rough-rat/papajbadge/muzg/papajbadge.kicad_pcb

## KiCad design muzg/papajbadge.kicad_pcb (2025-09-09)

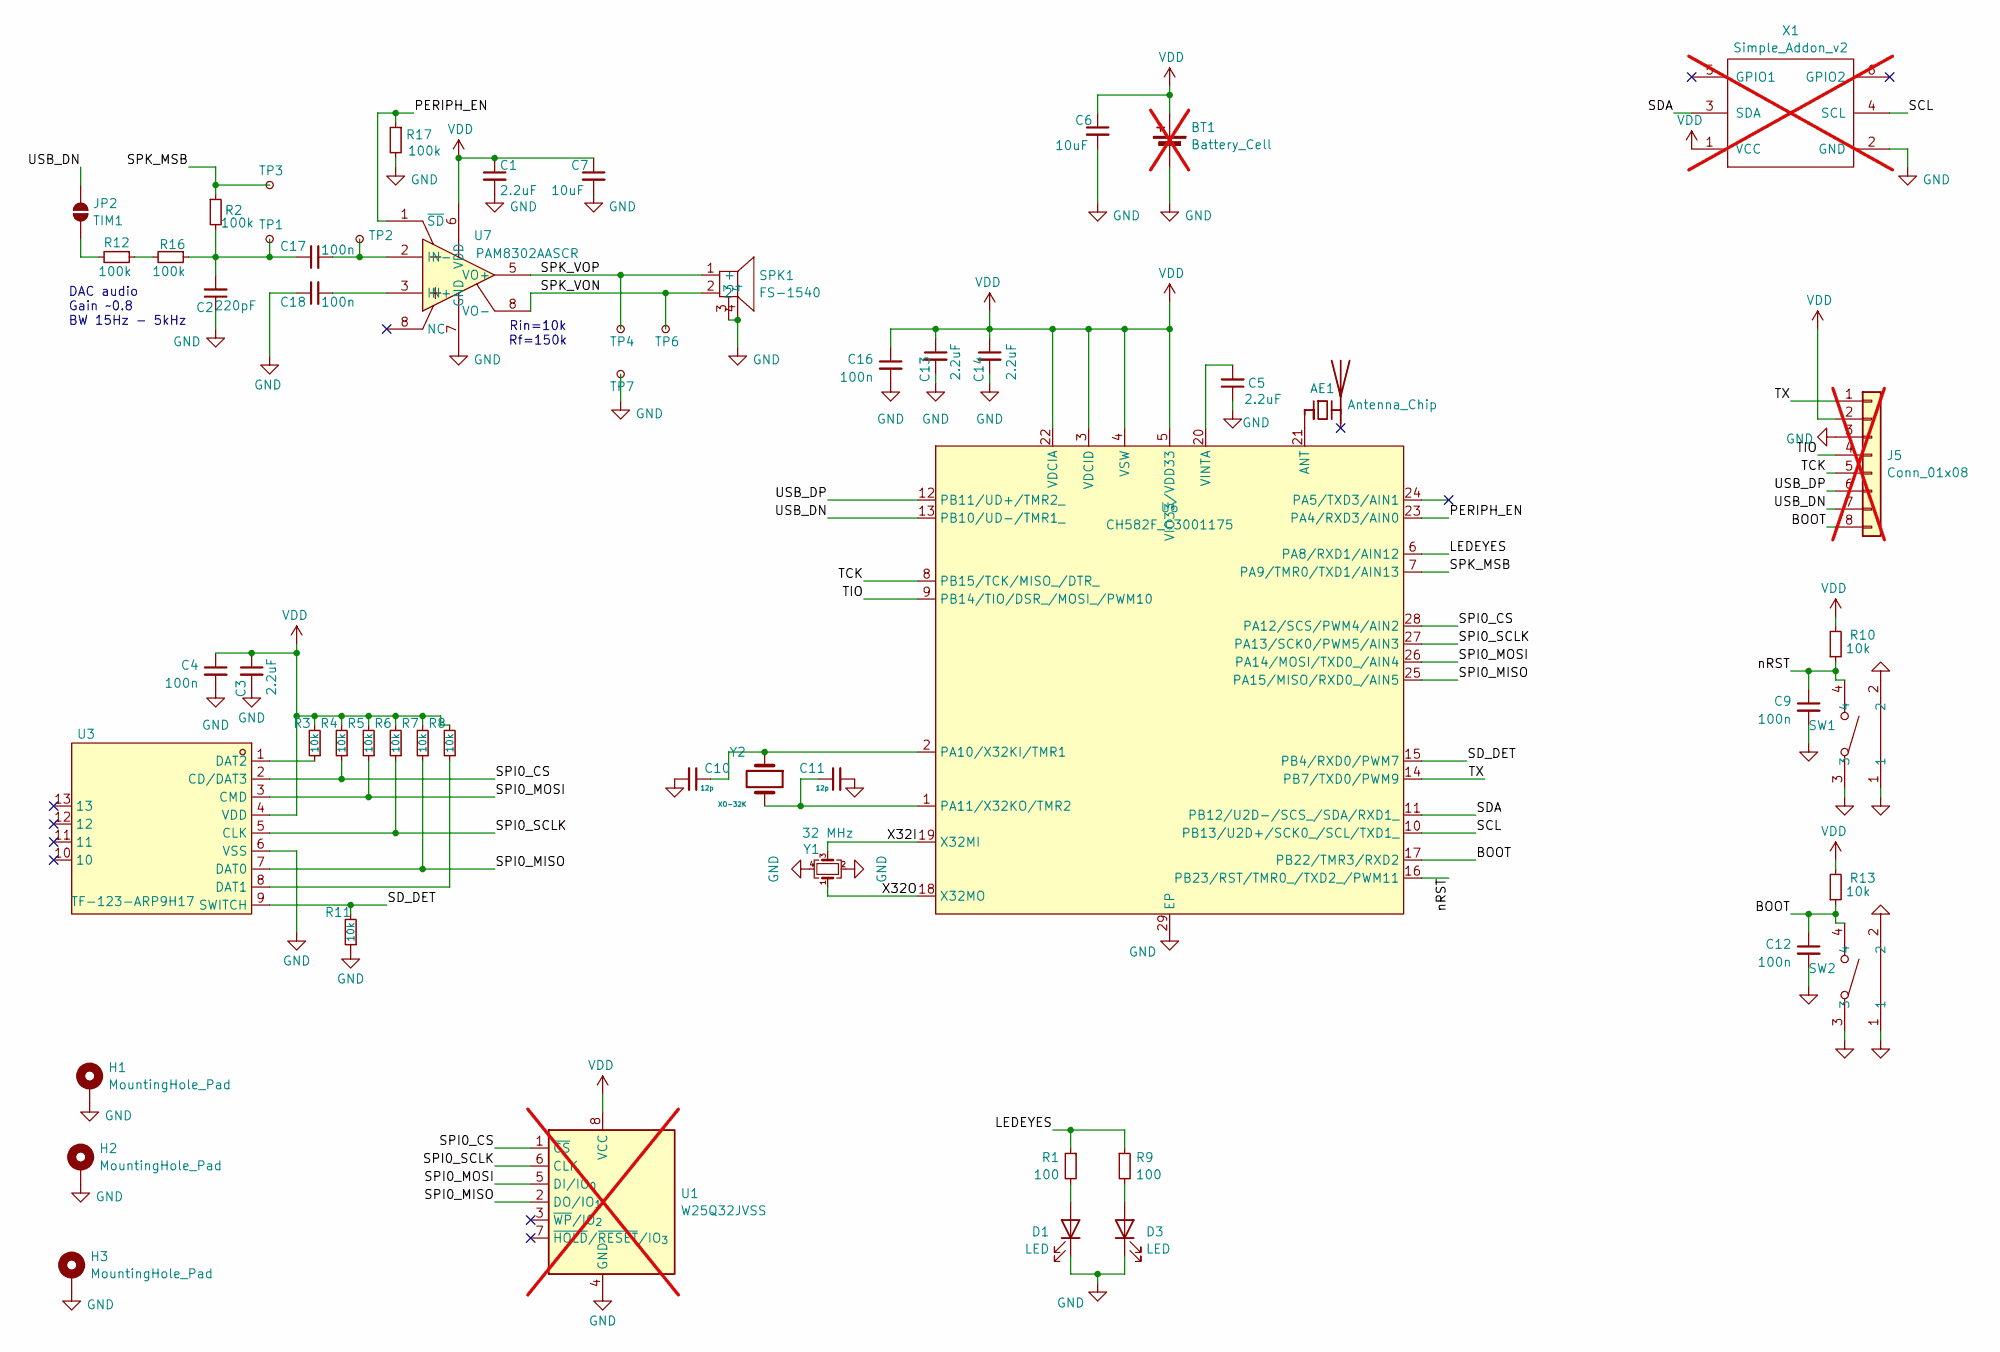
[picture p2: schematic papajbadge.kicad_sch]

Parts:
AE1: Antenna_Chip; Johanson_2450AT18x100; LCSC C127629
BT1: Battery_Cell; BatteryHolder_Multicomp_BC-2001_1x2032; not fitted
C1, C3, C5, C13, C14: 2.2uF; C_0402_1005Metric
C2: 220pF; C_0402_1005Metric
C4, C9, C12, C16, C17, C18: 100n; C_0402_1005Metric
C6, C7: 10uF; C_0603_1608Metric
C10, C11: 12p; C_0402_1005Metric
D1, D3: LED; LED_0603_1608Metric
H1, H2, H3: MountingHole_Pad; MountingHole_2.7mm_M2.5_DIN965_Pad
J5: Conn_01x08; PinSocket_1x08_P2.54mm_Vertical; not fitted
JP2: TIM1; SolderJumper-2_P1.3mm_Open_RoundedPad1.0x1.5mm
R1, R9: 100; R_0402_1005Metric
R2, R12, R16, R17: 100k; R_0402_1005Metric
R3, R4, R5, R6, R7, R8, R10, R11, R13: 10k; R_0402_1005Metric
SPK1: FS-1540; BUZ-SMD_5P-L15.0-W15.0-P13.7-BL; LCSC C482341
SW1, SW2: TS24CA; SW-SMD_TS24CA; LCSC C393942
TP1, TP2, TP3: RX; TestPoint_Pad_D0.6mm
TP4, TP6, TP7: RX; TestPoint_Pad_D1.0mm
U1: W25Q32JVSS; SOIC-8_5.3x5.3mm_P1.27mm; not fitted
U3: TF-123-ARP9H17; TF-SMD_TF-123-ARP9H15; LCSC C2982548
U6: CH582F_C3001175; QFN-28_L4.0-W4.0-P0.40-BL-EP2.8; LCSC C3001175
U7: PAM8302AASCR; MSOP-8_L3.0-W3.0-P0.65-LS5.0-BL; LCSC C113367
X1: Simple_Addon_v2; PinHeader_2x03_P2.54mm_Vertical; not fitted
Y1: 32 MHz; Crystal_SMD_2016-4Pin_2.0x1.6mm; LCSC C2682773
Y2: XO-32K; Crystal_SMD_2012-2Pin_2.0x1.2mm; LCSC C7500573

Connections:
/BOOT: C12.1, J5.8, R13.1, SW2.4, U6.17 (PB22/TMR3/RXD2)
/LEDEYES: R1.1, R9.1, U6.6 (PA8/RXD1/AIN12)
/PERIPH_EN: R17.1, U6.23 (PA4/RXD3/AIN0), U7.1 (~SD)
/SCL: U6.10 (PB13/U2D+/SCK0_/SCL/TXD1_), X1.4 (SCL)
/SDA: U6.11 (PB12/U2D-/SCS_/SDA/RXD1_), X1.3 (SDA)
/SD_DET: R11.2, U3.9 (SWITCH), U6.15 (PB4/RXD0/PWM7)
/SPI0_CS: R4.1, U1.1 (~CS), U3.2 (CD/DAT3), U6.28 (PA12/SCS/PWM4/AIN2)
/SPI0_MISO: R7.1, U1.2 (DO/IO_{1}), U3.7 (DAT0), U6.25 (PA15/MISO/RXD0_/AIN5)
/SPI0_MOSI: R5.1, U1.5 (DI/IO_{0}), U3.3 (CMD), U6.26 (PA14/MOSI/TXD0_/AIN4)
/SPI0_SCLK: R6.1, U1.6 (CLK), U3.5 (CLK), U6.27 (PA13/SCK0/PWM5/AIN3)
/SPK_MSB: R2.1, TP3.1, U6.7 (PA9/TMR0/TXD1/AIN13)
/SPK_VON: SPK1.2, TP6.1, U7.8 (VO-)
/SPK_VOP: SPK1.1 (+), TP4.1, U7.5 (VO+)
/TCK: J5.5, U6.8 (PB15/TCK/MISO_/DTR_)
/TIO: J5.4, U6.9 (PB14/TIO/DSR_/MOSI_/PWM10)
/TX: J5.1, U6.14 (PB7/TXD0/PWM9)
/USB_DN: J5.7, JP2.2 (B), U6.13 (PB10/UD-/TMR1_)
/USB_DP: J5.6, U6.12 (PB11/UD+/TMR2_)
/X32I: U6.19 (X32MI), Y1.3
/X32O: U6.18 (X32MO), Y1.1
/nRST: C9.1, R10.1, SW1.4, U6.16 (PB23/RST/TMR0_/TXD2_/PWM11)
GND: BT1.2 (-), C1.2, C2.1, C3.2, C4.2, C5.1, C6.2, C7.2, C9.2, C10.2, C11.2, C12.2, C13.2, C14.2, C16.2, C18.1, D1.1 (K), D3.1 (K), H1.1, H2.1, H3.1, J5.3, R11.1, R17.2, SPK1.3, SPK1.4, SW1.1, SW1.2, SW1.3, SW2.1, SW2.2, SW2.3, TP7.1, U1.4 (GND), U3.6 (VSS), U6.29 (EP), U7.7 (GND), X1.2 (GND), Y1.2, Y1.4
unnamed: AE1.1 (FEED), U6.21 (ANT)
unnamed: C2.2, C17.1, R2.2, R16.1, TP1.1
unnamed: D1.2 (A), R1.2
unnamed: D3.2 (A), R9.2
unnamed: JP2.1 (A), R12.2
unnamed: R12.1, R16.2
unnamed: R8.1, U3.8 (DAT1)
unnamed: R3.1, U3.1 (DAT2)
unnamed: C10.1, U6.2 (PA10/X32KI/TMR1), Y2.1
unnamed: C11.1, U6.1 (PA11/X32KO/TMR2), Y2.2
unnamed: C5.2, U6.20 (VINTA)
unnamed: C18.2, U7.3 (IN+)
unnamed: C17.2, TP2.1, U7.2 (IN-)
VDD: BT1.1 (+), C1.1, C3.1, C4.1, C6.1, C7.1, C13.1, C14.1, C16.1, J5.2, R3.2, R4.2, R5.2, R6.2, R7.2, R8.2, R10.2, R13.2, U1.8 (VCC), U3.4 (VDD), U6.3 (VDCID), U6.4 (VSW), U6.5 (VIO33/VDD33), U6.22 (VDCIA), U7.6 (VDD), X1.1 (VCC)

Notes on the sheet:
Rin=10k Rf=150k
DAC audio Gain ~0.8 BW 15Hz - 5kHz

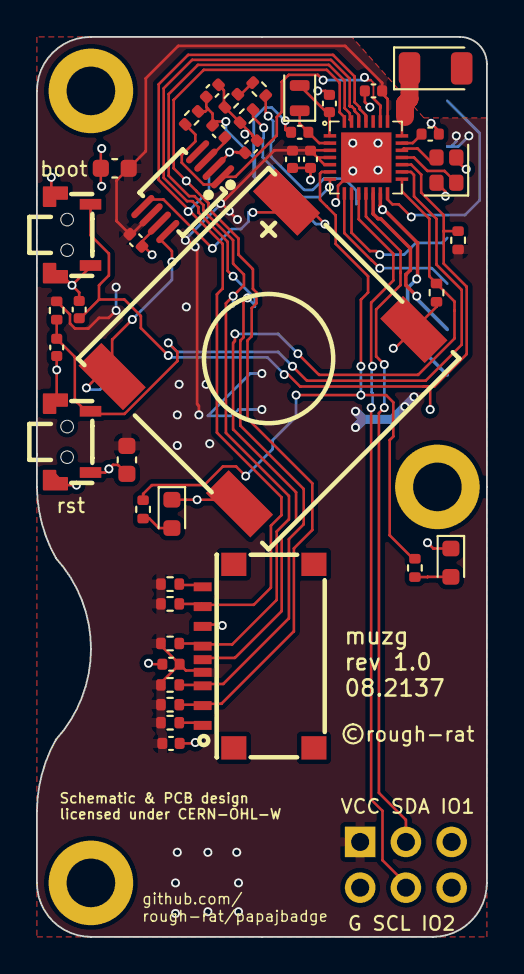
[picture p3: board muzg/papajbadge.kicad_pcb from above]

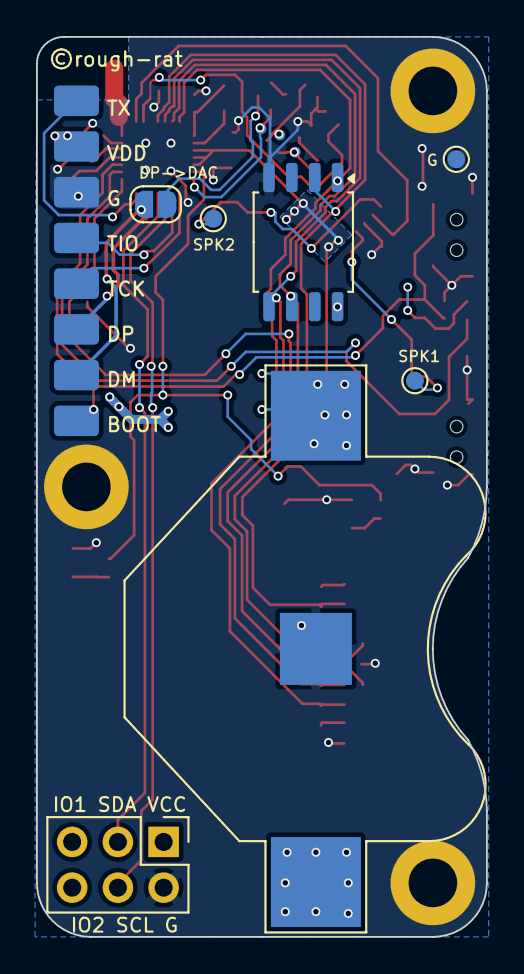
[picture p4: board muzg/papajbadge.kicad_pcb from below]

Board: 2 copper layers, 25.0 x 50.0 mm, 56 parts (12 on the bottom side), 36 nets.
