rough-rat/papajbadge/papajbadge/papajbadge.kicad_pcb

## KiCad design papajbadge/papajbadge.kicad_pcb (2025-07-09, an earlier design)

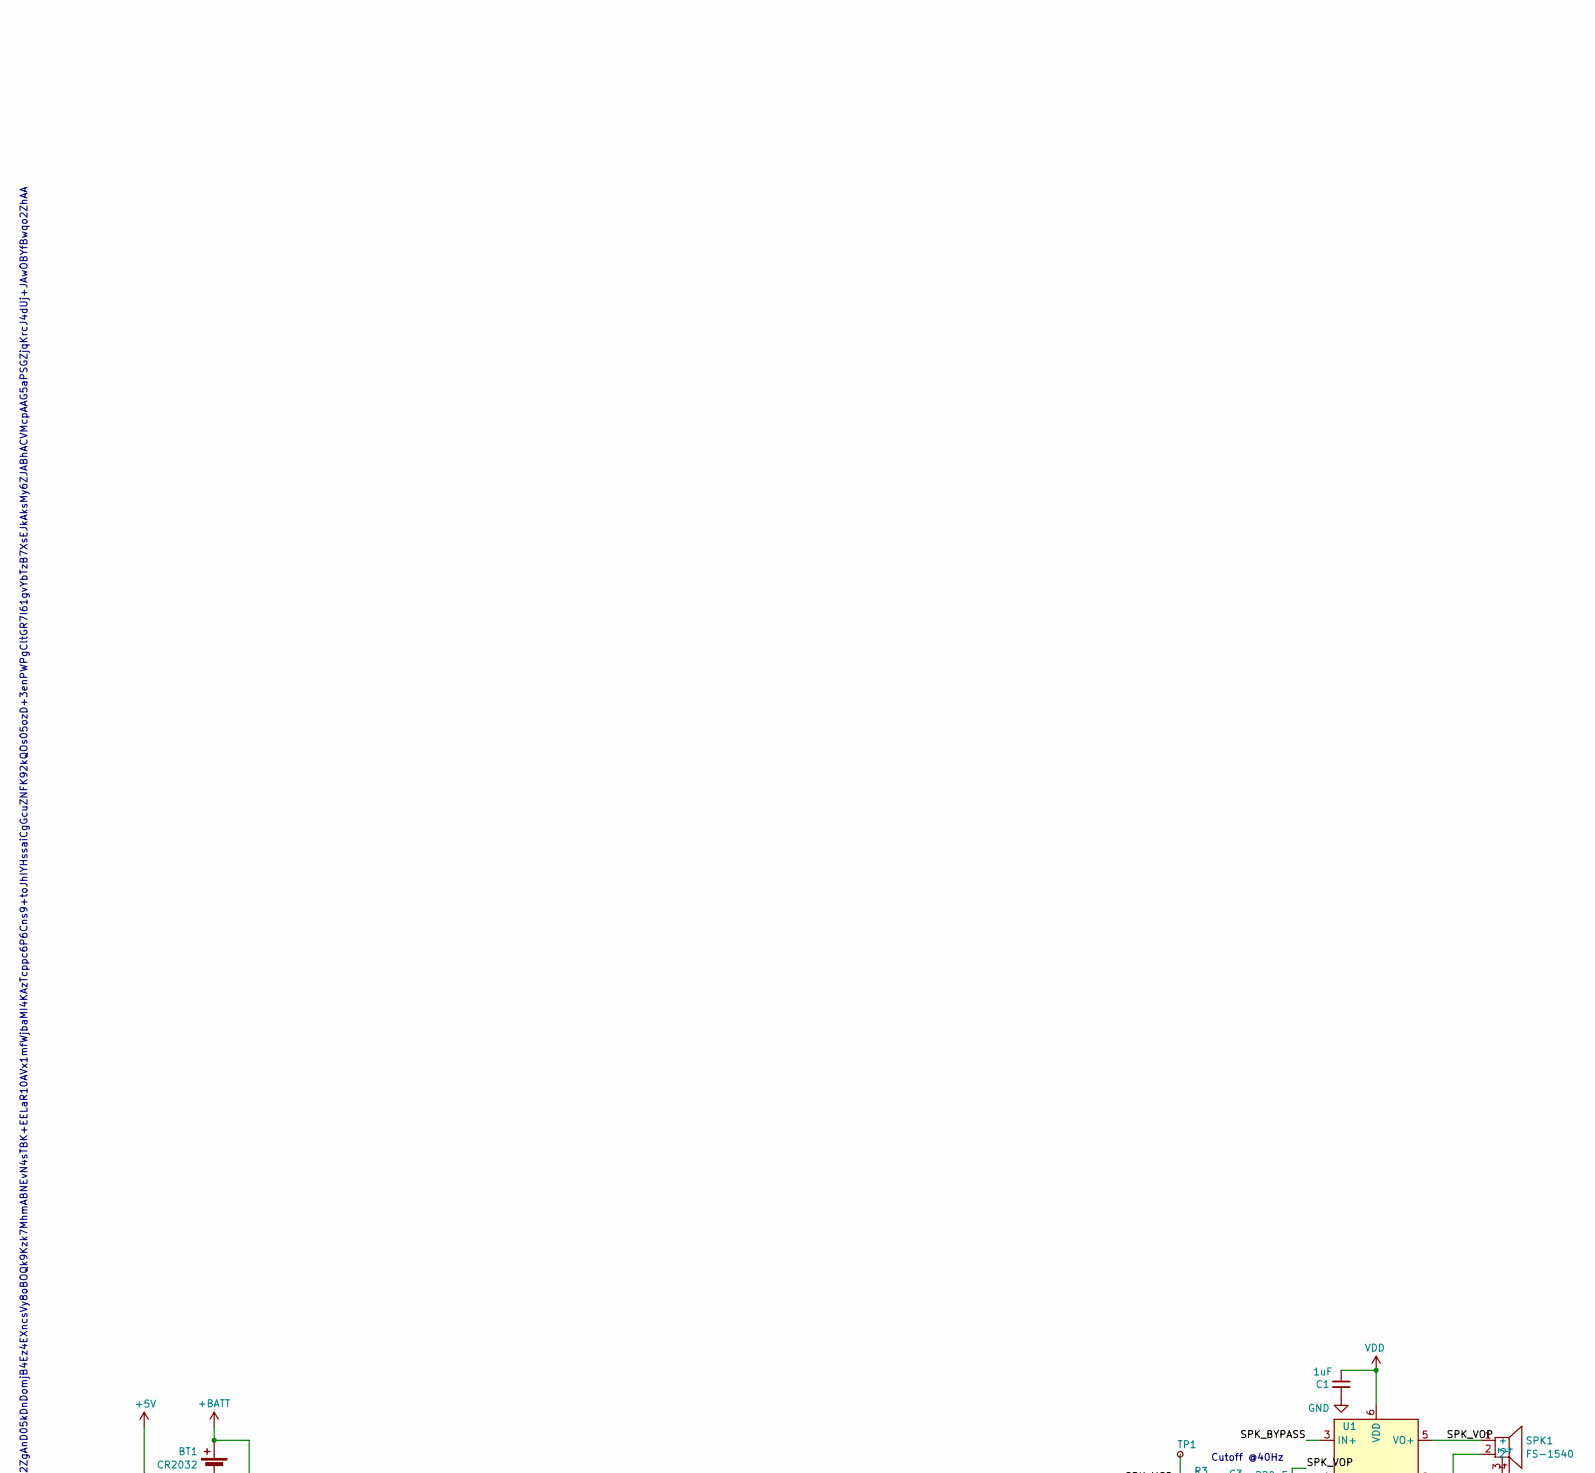
[picture p5: schematic papajbadge.kicad_sch, part in row 1, column 1]

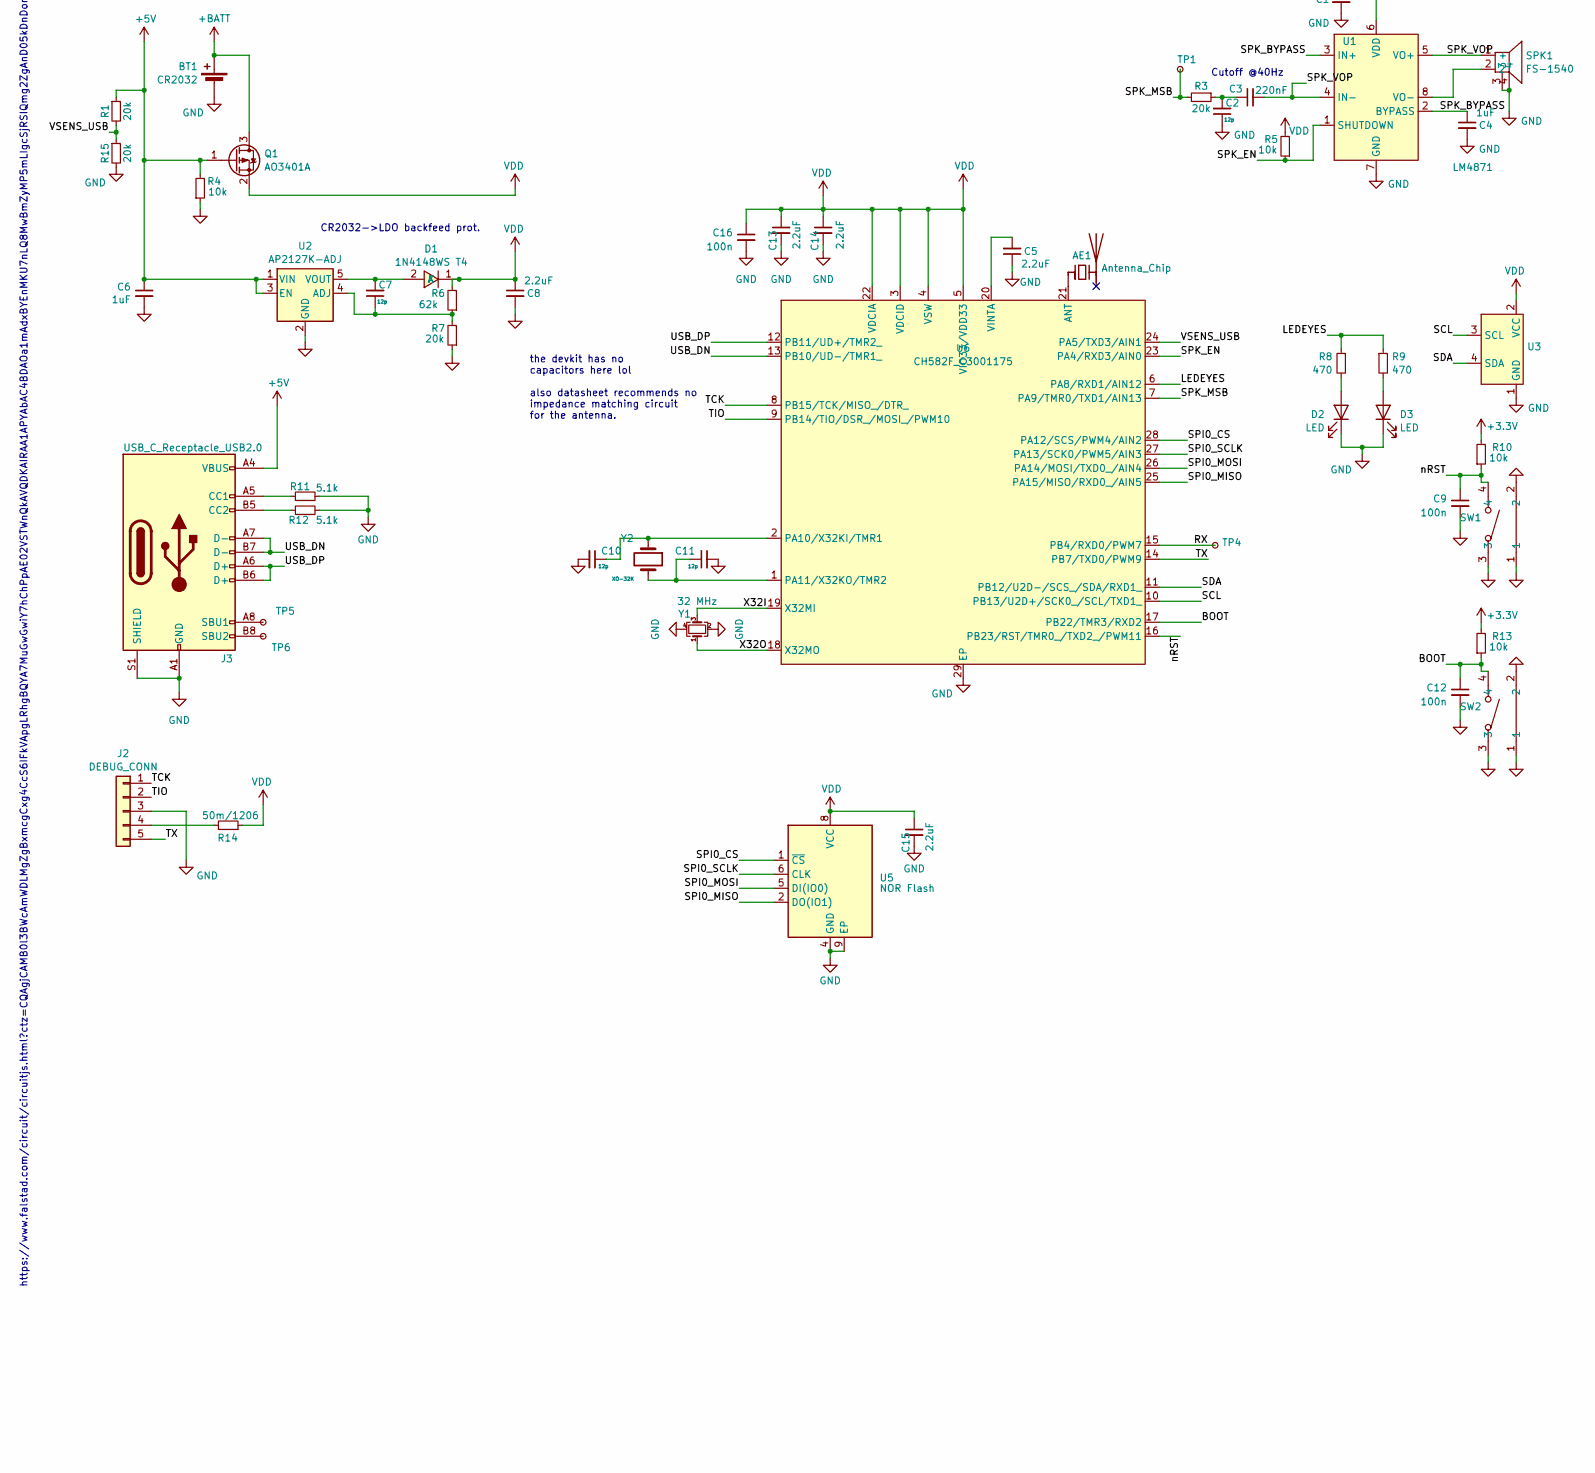
[picture p6: schematic papajbadge.kicad_sch, part in row 2, column 1]

Parts:
AE1: Antenna_Chip; Johanson_2450AT18x100; LCSC C127629
BT1: CR2032; BatteryHolder_Multicomp_BC-2001_1x2032
C1, C4: 1uF; C_0402_1005Metric
C2, C7, C10, C11: 12p; C_0402_1005Metric; LCSC C1547
C3: 220nF; C_0402_1005Metric
C5, C8, C13, C14, C15: 2.2uF; C_0402_1005Metric
C6: 1uF; C_0402_1005Metric; LCSC C52923
C9, C12, C16: 100n; C_0402_1005Metric; LCSC C1525
D1: 1N4148WS T4; SOD-323_L1.8-W1.3-LS2.5-RD; LCSC Part C2128
D2, D3: LED; eyeled
J2: DEBUG_CONN; PinHeader_1x05_P2.54mm_Vertical
J3: USB_C_Receptacle_USB2.0; USB_C_Receptacle_HRO_TYPE-C-31-M-12; LCSC C165948
Q1: AO3401A; SOT-23
R1, R3, R7, R15: 20k; R_0402_1005Metric; LCSC C25741
R4, R5: 10k; R_0402_1005Metric; LCSC C25741
R6: 62k; R_0805_2012Metric; LCSC C17783
R8, R9: 470; LED_0805_2012Metric_Pad1.15x1.40mm_HandSolder
R10, R13: 10k; R_0402_1005Metric
R11, R12: 5.1k; R_0402_1005Metric
R14: 50m/1206; R_1206_3216Metric
SPK1: FS-1540; BUZ-SMD_5P-L15.0-W15.0-P13.7-BL; LCSC Part C482341
SW1, SW2: TS24CA; SW-SMD_TS24CA; LCSC C393942
TP1, TP4, TP5, TP6: RX; TestPoint_Pad_D0.6mm
U1: LM4871; SOIC-8_L4.9-W3.9-P1.27-LS6.0-BL; LCSC Part C7494970
U2: AP2127K-ADJ; SOT-23-5; LCSC C96343
U3: PinHeader_1x04_P2.54mm_Vertical
U5: NOR Flash; USON-8_2x3; LCSC C2843335
U6: CH582F_C3001175; QFN-28_L4.0-W4.0-P0.40-BL-EP2.8; LCSC Part C3001175
Y1: 32 MHz; Crystal_SMD_2016-4Pin_2.0x1.6mm
Y2: XO-32K; Crystal_SMD_2012-2Pin_2.0x1.2mm; LCSC C7500573

Connections:
+3.3V: R10.2, R13.2
+5V: C6.1, J3.A4 (VBUS), J3.A9 (VBUS), J3.B4 (VBUS), J3.B9 (VBUS), Q1.1 (G), R1.1, R4.2, U2.1 (VIN), U2.3 (EN)
+BATT: BT1.1 (+), Q1.3 (D)
/BOOT: C12.1, R13.1, SW2.4, U6.17 (PB22/TMR3/RXD2)
/LEDEYES: R8.1, R9.1, U6.6 (PA8/RXD1/AIN12)
/RX: TP4.1, U6.15 (PB4/RXD0/PWM7)
/SCL: U3.3 (SCL), U6.10 (PB13/U2D+/SCK0_/SCL/TXD1_)
/SDA: U3.4 (SDA), U6.11 (PB12/U2D-/SCS_/SDA/RXD1_)
/SPI0_CS: U5.1 (~CS), U6.28 (PA12/SCS/PWM4/AIN2)
/SPI0_MISO: U5.2 (DO(IO1)), U6.25 (PA15/MISO/RXD0_/AIN5)
/SPI0_MOSI: U5.5 (DI(IO0)), U6.26 (PA14/MOSI/TXD0_/AIN4)
/SPI0_SCLK: U5.6 (CLK), U6.27 (PA13/SCK0/PWM5/AIN3)
/SPK_BYPASS: C4.1, U1.2 (BYPASS), U1.3 (IN+)
/SPK_EN: R5.1, U1.1 (SHUTDOWN), U6.23 (PA4/RXD3/AIN0)
/SPK_MSB: R3.2, TP1.1, U6.7 (PA9/TMR0/TXD1/AIN13)
/SPK_VOP: C3.2, SPK1.1 (+), U1.4 (IN-), U1.5 (VO+)
/TCK: J2.1, U6.8 (PB15/TCK/MISO_/DTR_)
/TIO: J2.2, U6.9 (PB14/TIO/DSR_/MOSI_/PWM10)
/TX: J2.5, U6.14 (PB7/TXD0/PWM9)
/USB_DN: J3.A7 (D-), J3.B7 (D-), U6.13 (PB10/UD-/TMR1_)
/USB_DP: J3.A6 (D+), J3.B6 (D+), U6.12 (PB11/UD+/TMR2_)
/VSENS_USB: R1.2, R15.1, U6.24 (PA5/TXD3/AIN1)
/X32I: U6.19 (X32MI), Y1.3
/X32O: U6.18 (X32MO), Y1.1
/nRST: C9.1, R10.1, SW1.4, U6.16 (PB23/RST/TMR0_/TXD2_/PWM11)
GND: BT1.2 (-), C1.2, C2.1, C4.2, C5.1, C6.2, C8.2, C9.2, C10.2, C11.2, C12.2, C13.2, C14.2, C15.2, C16.2, D2.1 (K), D3.1 (K), J2.3, J3.A1 (GND), J3.A12 (GND), J3.B1 (GND), J3.B12 (GND), J3.S1 (SHIELD), R4.1, R7.1, R11.2, R12.2, R15.2, SPK1.3, SPK1.4, SW1.1, SW1.2, SW1.3, SW2.1, SW2.2, SW2.3, U1.7 (GND), U2.2 (GND), U3.1 (GND), U5.4 (GND), U5.9 (EP), U6.29 (EP), Y1.2, Y1.4
unnamed: AE1.1 (FEED), U6.21 (ANT)
unnamed: C2.2, C3.1, R3.1
unnamed: C7.2, D1.2 (A), U2.5 (VOUT)
unnamed: D2.2 (A), R8.2
unnamed: D3.2 (A), R9.2
unnamed: J2.4, R14.2
unnamed: J3.A5 (CC1), R11.1
unnamed: J3.B5 (CC2), R12.1
unnamed: J3.A8 (SBU1), TP5.1
unnamed: J3.B8 (SBU2), TP6.1
unnamed: SPK1.2, U1.8 (VO-)
unnamed: C7.1, R6.1, R7.2, U2.4 (ADJ)
unnamed: C10.1, U6.2 (PA10/X32KI/TMR1), Y2.1
unnamed: C11.1, U6.1 (PA11/X32KO/TMR2), Y2.2
unnamed: C5.2, U6.20 (VINTA)
VDD: C1.1, C8.1, C13.1, C14.1, C15.1, C16.1, D1.1 (K), Q1.2 (S), R5.2, R6.2, R14.1, U1.6 (VDD), U3.2 (VCC), U5.8 (VCC), U6.3 (VDCID), U6.4 (VSW), U6.5 (VIO33/VDD33), U6.22 (VDCIA)

Notes on the sheet:
CR2032->LDO backfeed prot.
Cutoff @40Hz
the devkit has no capacitors here lol also datasheet recommends no impedance matching circuit for the antenna.
https://www.falstad.com/circuit/circuitjs.html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…

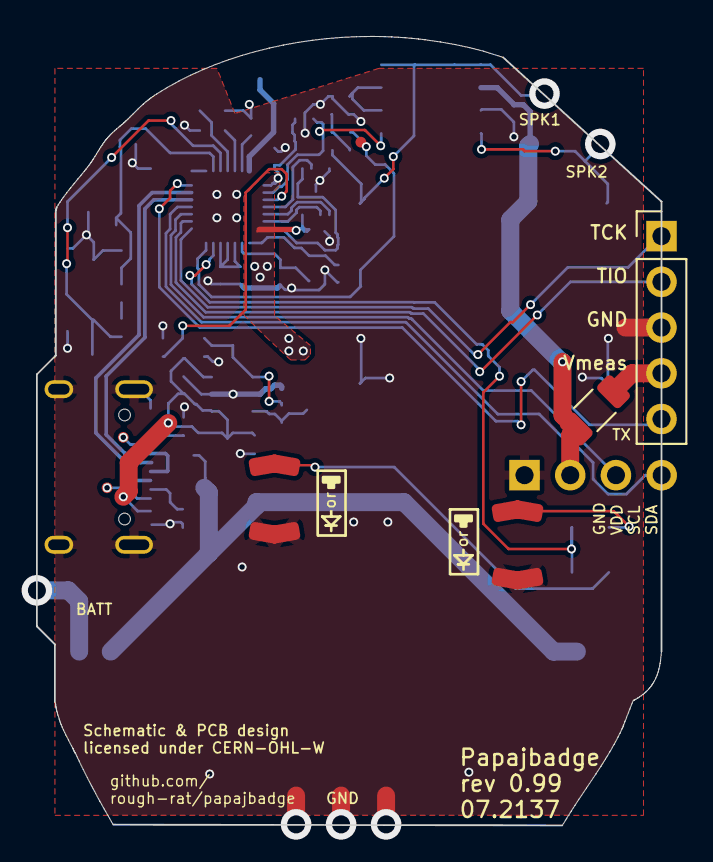
[picture p7: board papajbadge/papajbadge.kicad_pcb from above]

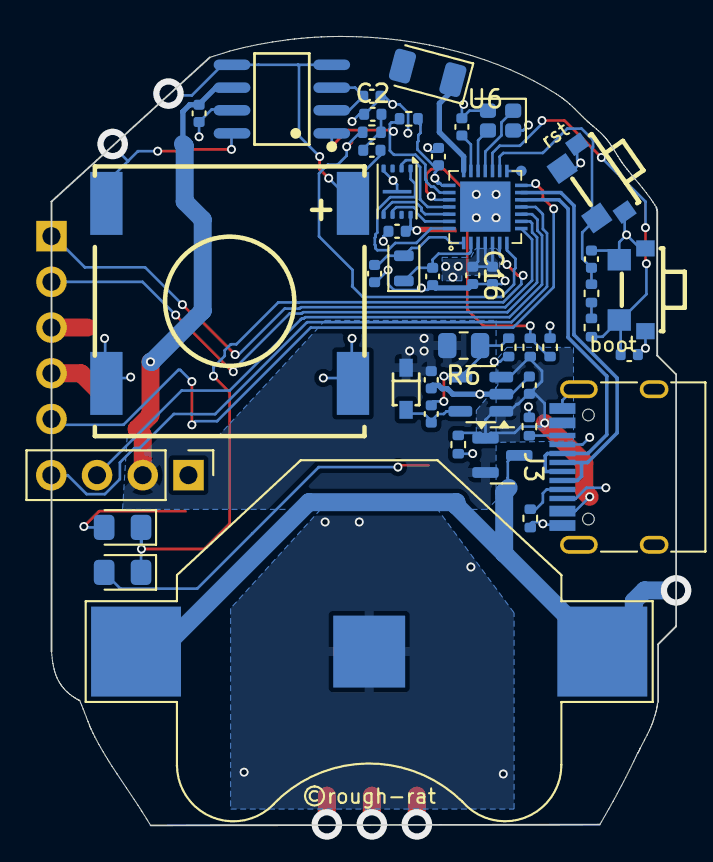
[picture p8: board papajbadge/papajbadge.kicad_pcb from below]

Board: 2 copper layers, 34.7 x 43.8 mm, 52 parts (45 on the bottom side), 42 nets.
