rough-rat/papajbadge/papajbadge.kicad_pcb

## KiCad design papajbadge.kicad_pcb (2025-07-07)

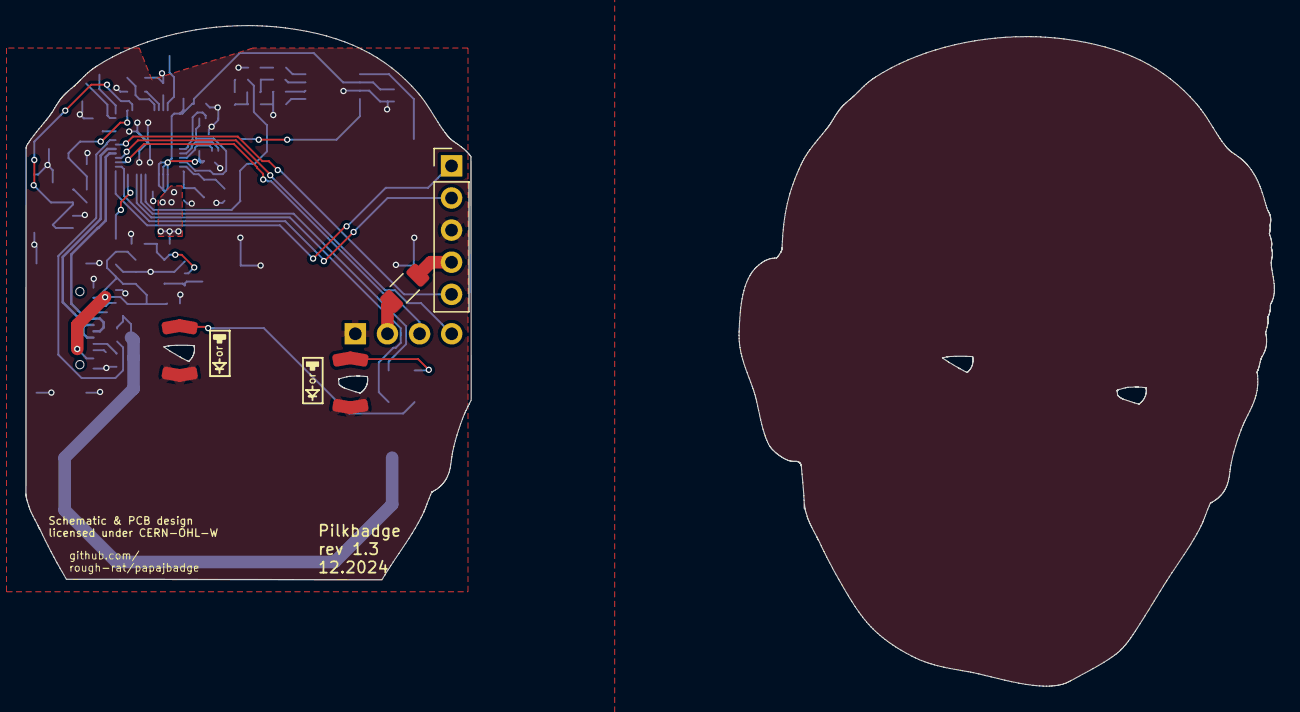
[picture p9: board papajbadge.kicad_pcb from above]

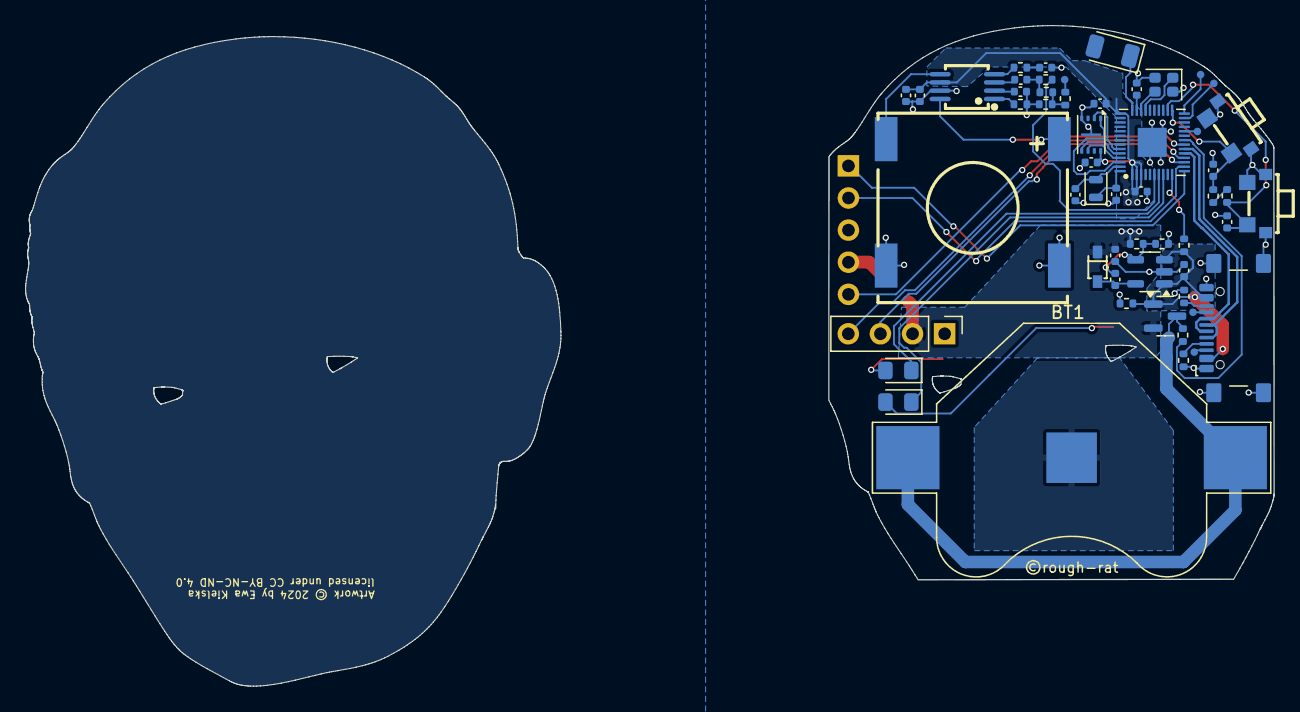
[picture p10: board papajbadge.kicad_pcb from below]

Board: 2 copper layers, 35.2 x 43.8 mm, 58 parts (54 on the bottom side), 51 nets.

Parts:
AE101: Antenna_Chip; Johanson_2450AT18x100
BT1: CR2032; BatteryHolder_Multicomp_BC-2001_1x2032
C1, C2, C8, C102, C107: 2.2uF; C_0402_1005Metric
C5, C101, C109: 12p; C_0402_1005Metric
C10: 1u; C_0402_1005Metric
C13, C19, C103, C106, C108: 100n; C_0402_1005Metric
C104, C105: 1uF; C_0402_1005Metric
D1, D2: LED; eyeled
D101: 1N4148WS T4; SOD-323_L1.8-W1.3-LS2.5-RD
J101: USB_C_Receptacle_USB2.0_16P; USB_C_Receptacle_GCT_USB4110
J102: DEBUG_CONN; PinHeader_1x05_P2.54mm_Vertical
Q3: AO3401A; SOT-23
R1, R2: 470; LED_0805_2012Metric_Pad1.15x1.40mm_HandSolder
R4, R5: 5.1k; R_0402_1005Metric
R24, R102, R107, R110, R113: 10k; R_0402_1005Metric
R101: 50m/1206; R_1206_3216Metric
R103: 56.2k; R_0402_1005Metric
R104: 18k; R_0402_1005Metric
R105, R109, R111, R112: 330k; R_0402_1005Metric
R106, R108: 33k; R_0402_1005Metric
SPK101: FS-1540; BUZ-SMD_5P-L15.0-W15.0-P13.7-BL
SW1, SW101: TS24CA; SW-SMD_TS24CA
TP2, TP101, TP102, TP103, TP104, TP105: RX; TestPoint_Pad_D0.6mm
U1: CH582M; CH582-QFN-48-1EP_5x5mm_P0.35mm_EP3.7x3.7mm
U5: NOR Flash; USON-8_2x3
U101: NS4150; MSOP-8_L3.0-W3.0-P0.65-LS5.0-BL
U102: AP2127K-ADJ; SOT-23-5
U103: PinHeader_1x04_P2.54mm_Vertical
Y1: 32 MHz; Crystal_SMD_2016-4Pin_2.0x1.6mm
Y2: XO-32K; Crystal_SMD_2012-2Pin_2.0x1.2mm

Connections:
+3.3V: R24.2, R113.2
+5V: C10.1, J101.A4 (VBUS), J101.A9 (VBUS), J101.B4 (VBUS), J101.B9 (VBUS), Q3.1 (G), R102.2, R112.2, U102.1 (VIN), U102.3 (EN)
+BATT: BT1.1 (+), Q3.3 (D), R111.1
/BOOT: C108.1, R113.1, SW101.4, U1.26 (PB22)
/LEDEYE1: R1.1, U1.7 (PB9)
/LEDEYE2: R2.1, U1.8 (PB8)
/PWM6: TP101.1, U1.24 (PB0)
/PWM7: TP102.1, U1.23 (PB1)
/RX: TP2.1, U1.20 (PB4)
/SCL: U1.13 (PB13), U103.3 (SCL)
/SDA: U1.14 (PB12), U103.4 (SDA)
/SPI0_CS: U1.46 (PA12), U5.1 (~CS)
/SPI0_MISO: U1.43 (PA15), U5.2 (DO(IO1))
/SPI0_MOSI: U1.44 (PA14), U5.5 (DI(IO0))
/SPI0_SCLK: U1.45 (PA13), U5.6 (CLK)
/SPK_EN: R107.2, U101.1 (CTRL)
/SPK_MSB: R108.1, U1.6 (PA9)
/TCK: J102.1, U1.11 (PB15)
/TIO: J102.2, U1.12 (PB14)
/TX: J102.5, U1.17 (PB7)
/USB_DN: J101.A7 (D-), J101.B7 (D-), U1.16 (PB10)
/USB_DP: J101.A6 (D+), J101.B6 (D+), U1.15 (PB11)
/VSENS_CR2032: R111.2, U1.18 (PB6)
/VSENS_USB: R112.1, U1.10 (PB16)
/X32I: U1.31 (X32MO), Y1.1
/X32O: U1.32 (X32MI), Y1.3
/nRST: C19.1, R24.1, SW1.4, U1.25 (PB23)
GND: BT1.2 (-), C1.1, C2.2, C5.2, C8.2, C10.2, C19.2, C101.2, C102.2, C103.1, C104.2, C105.2, C106.1, C107.2, C108.2, D1.1 (K), D2.1 (K), J101.A1 (GND), J101.A12 (GND), J101.B1 (GND), J101.B12 (GND), J101.S1 (SHIELD), J102.3, R4.2, R5.2, R102.1, R104.1, R107.1, R110.1, SPK101.3, SPK101.4, SW1.1, SW1.2, SW1.3, SW101.1, SW101.2, SW101.3, U1.49 (GND), U5.4 (GND), U5.9 (EP), U101.7 (GND), U102.2 (GND), U103.1 (GND), Y1.2, Y1.4
unnamed: AE101.1 (FEED), U1.34 (ANT)
unnamed: C13.1, R105.1, R108.2
unnamed: C103.2, R106.2
unnamed: D1.2 (A), R1.2
unnamed: D2.2 (A), R2.2
unnamed: C109.2, D101.2 (A), U102.5 (VOUT)
unnamed: J101.A5 (CC1), R4.1
unnamed: J101.B5 (CC2), R5.1
unnamed: J101.A8 (SBU1), TP104.1
unnamed: J101.B8 (SBU2), TP105.1
unnamed: J102.4, R101.2
unnamed: R105.2, R109.1, R110.2
unnamed: R109.2, TP103.1
unnamed: SPK101.1 (+), U101.8 (VoP)
unnamed: C5.1, U1.48 (PA10), Y2.1
unnamed: C101.1, U1.47 (PA11), Y2.2
unnamed: C1.2, U1.33 (VINTA)
unnamed: C105.1, U101.2 (Bypass)
unnamed: R106.1, U101.4 (INN)
unnamed: C13.2, U101.3 (INP)
unnamed: SPK101.2, U101.5 (VON)
unnamed: C109.1, R103.1, R104.2, U102.4 (ADJ)
VDD: C2.1, C8.1, C102.1, C104.1, C106.2, C107.1, D101.1 (K), Q3.2 (S), R101.1, R103.2, U1.1 (VDCID), U1.2 (VSW), U1.3 (VIO33), U1.35 (VDCIA), U5.8 (VCC), U101.6 (VCC), U103.2 (VCC)
