rough-rat/papajbadge/(commit log)

2025-07-06 add blasphemy
    [papajbadge.kicad_pcb, papajbadge.kicad_sch]
2025-07-06 mostly finish sch and placement
    [papajbadge.kicad_pcb, papajbadge.kicad_sch]
2025-07-07 finish pcb before review
    [papajbadge.kicad_pcb, papajbadge.kicad_sch]
2025-07-08 before order
    [papajbadge.kicad_pcb, papajbadge.kicad_sch]
2025-07-09 swap ble mcu, commit before order
    [papajbadge.kicad_pcb, papajbadge.kicad_sch]
2025-08-09 add WIP files
    [papajbadge.kicad_pcb, papajbadge.kicad_sch, rzulta.kicad_pcb, rzulta.kicad_sch]
