rough-rat/papajbadge/(notices)

Notices in the files:
papajbadge/papajbadge.kicad_pcb:
licensed under CERN-OHL-W
©rough-rat
papajbadge.kicad_pcb:
Artwork © 2024 by Ewa Kielska
licensed under CC BY-NC-ND 4.0
